def-fun/Marlin2SamplerWrapper/util/readme.md

# 工具脚本汇总

+ [calc_pos.py](calc_pos.py)计算样品瓶坐标

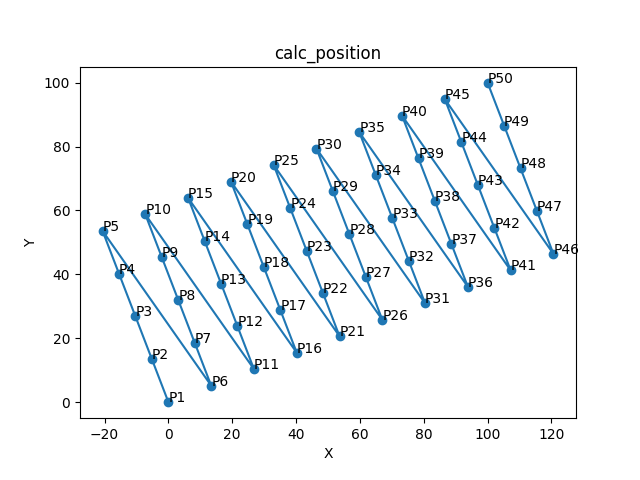
[picture p10: util/img/calc-position-plot.png]


生成和检查modbus通信payload

自动取样器上位机
