def-fun/Marlin2SamplerWrapper/doc/电子元件手册/LED/LED正负极区分.png

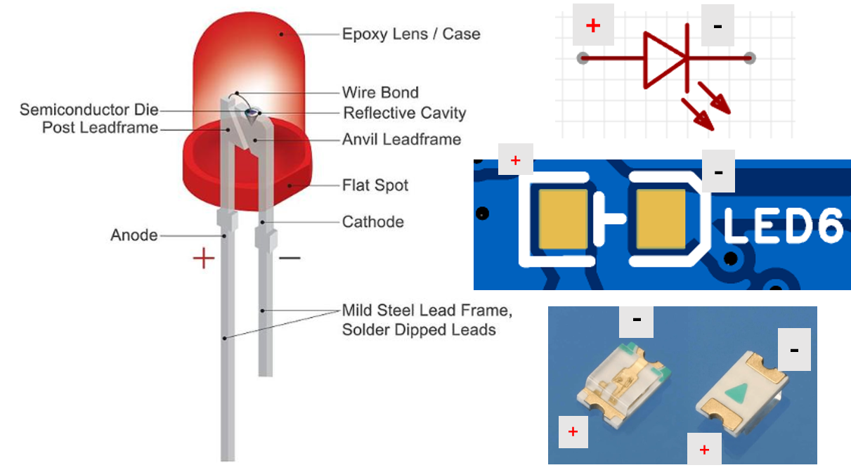
doc/电子元件手册/LED/LED正负极区分.png
