def-fun/Marlin2SamplerWrapper/img/calc_pos.jpg

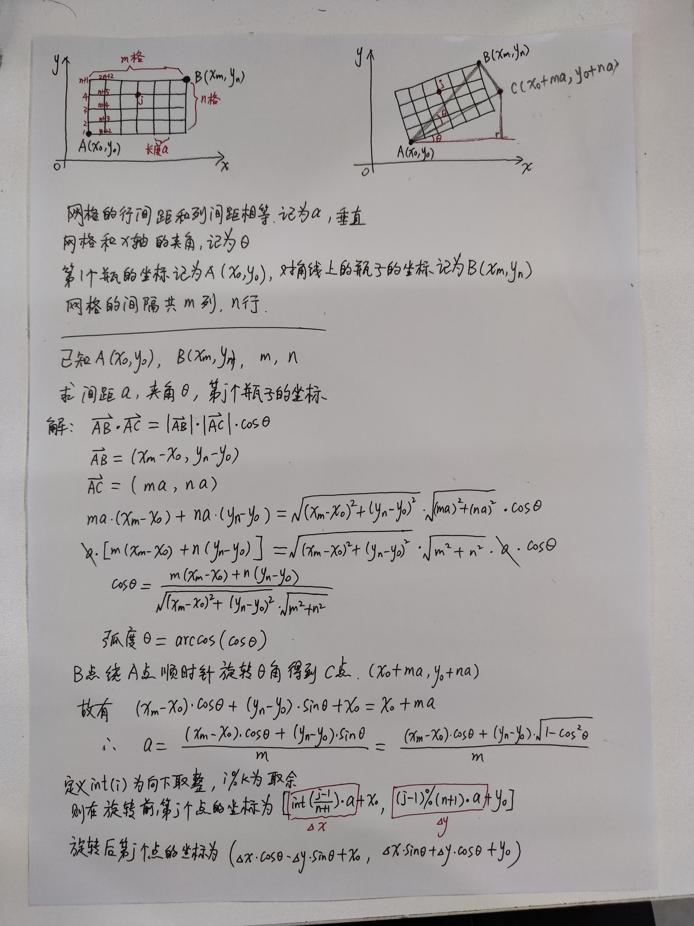
img/calc_pos.jpg
