def-fun/Marlin2SamplerWrapper/LCEDA-Pro/projects/Marlin2SamplerWrapper_backup/v1-20230606打板-图片.png

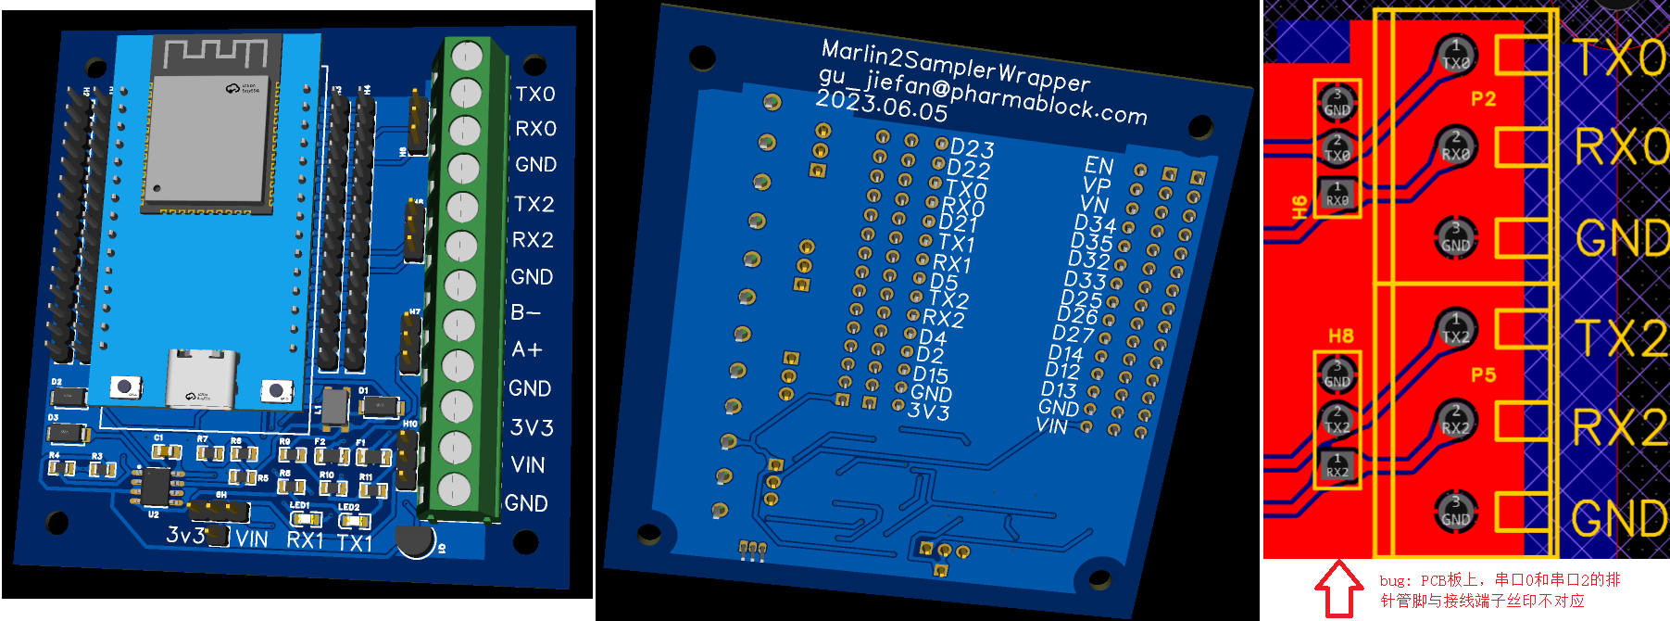
LCEDA-Pro/projects/Marlin2SamplerWrapper_backup/v1-20230606打板-图片.png
