def-fun/Marlin2SamplerWrapper/LCEDA-Pro/projects/Marlin2SamplerWrapper_backup/v2-20230615打板-图片.png

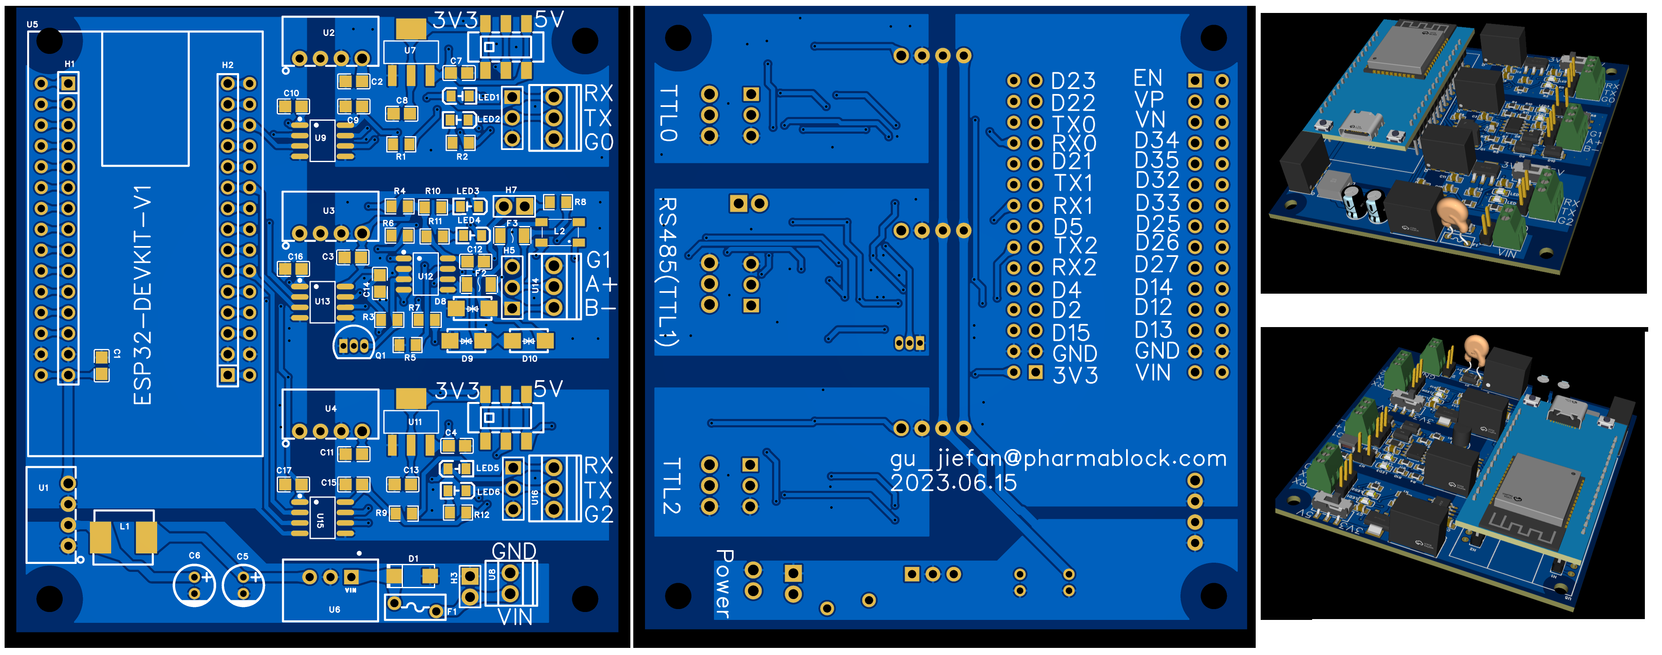
LCEDA-Pro/projects/Marlin2SamplerWrapper_backup/v2-20230615打板-图片.png
