def-fun/Marlin2SamplerWrapper/LCEDA-Pro/projects/Marlin2SamplerWrapper_backup/v3-20230623-PCB正面.png

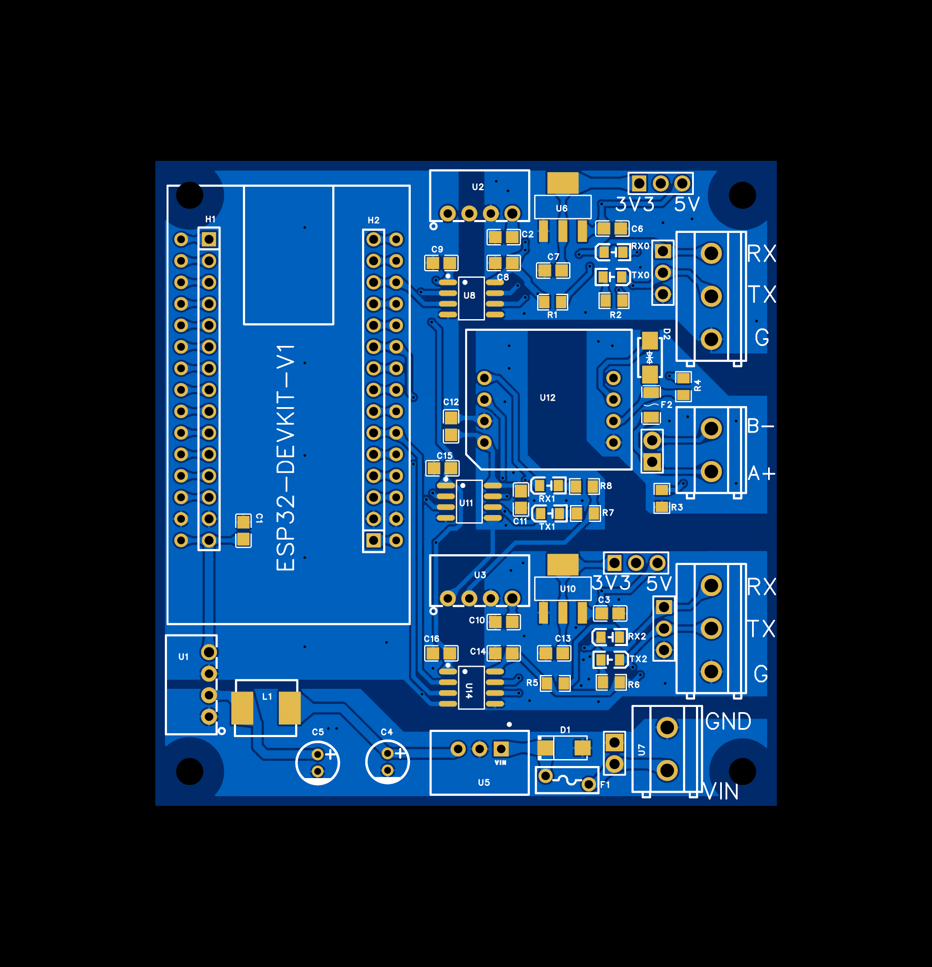
LCEDA-Pro/projects/Marlin2SamplerWrapper_backup/v3-20230623-PCB正面.png
