def-fun/Marlin2SamplerWrapper/LCEDA-Pro/projects/Marlin2SamplerWrapper_backup/v3-20230623-BOM.xlsx

No. | Quantity | Comment | Designator | Footprint | Manufacturer Part | Manufacturer | Supplier Part | Value | Primary Category | Secondary Category | Device | Name | Symbol
1 | 4 | 10uF | C1,C2,C3,C12 | C0805 | CL21A106KAYNNNE | SAMSUNG(三星) | C15850 | 10uF | 电容 | 贴片电容(MLCC) | CL21A106KAYNNNE_C15850 | 10uF | CL21A106KAYNNNE
2 | 2 | 22uF | C4,C5 | CAP-TH_BD5.0-P2.00-D0.8-FD | 50YXF22MEFC5X11 | rubycon(红宝石) | C88755 | 22uF | 电容 | 直插铝电解电容 | 50YXF22MEFC5X11 | 22uF | 50YXF22MEFC5X11
3 | 10 | 100nF | C6,C7,C8,C9,C10,C11,C13,C14,C15,C16 | C0805 | CC0805KRX7R9BB104 | YAGEO(国巨) | C49678 | 100nF | Capacitors | Multilayer Ceramic Capacitors MLCC - SMD/SMT | CC0805KRX7R9BB104 | 100nF | CL21A106KOQNNNE
4 | 1 | SS34 | D1 | SMA_L4.4-W2.6-LS5.0-RD | SS34 | Slkor(萨科微) | C408258 |  | 二极管 | 肖特基二极管 | SS34_C408258 | SS34 | SS34_C408258
5 | 1 | SMAJ12CA | D2 | SMA_L4.4-W2.6-LS5.0-BI | SMAJ12CA | MDD | C110042 |  | TVS/保险丝/板级保护 | 瞬态抑制二极管(TVS) | SMAJ12CA_C110042 | SMAJ12CA | SMAJ12CA-C110042
6 | 1 | BK60-050-DI | F1 | FUSE-TH_L7.4-W3.1-P5.10-D0.6-S1.00 | BK60-050-DI | Brightking(君耀电子) | C523023 |  | TVS/保险丝/板级保护 | 自恢复保险丝 | BK60-050-DI | BK60-050-DI | BK60-050-DI
7 | 1 | nSMD010 | F2 | F1206 | nSMD010 | 台湾陆海 | C70065 |  | TVS/保险丝/板级保护 | 自恢复保险丝 | nSMD010 | nSMD010 | nSMD010
8 | 2 | B-2100S15P-A110 | H1,H2 | HDR-TH_15P-P2.54-V-M | B-2100S15P-A110 | Ckmtw(灿科盟) | C124373 |  | 连接器 | 排针 | B-2100S15P-A110 | B-2100S15P-A110 | Header-Male-2.54_1x15
9 | 2 | PZ254V-11-02P | H3,H6 | HDR-TH_2P-P2.54-V-M | PZ254V-11-02P | XFCN(兴飞) | C492401 |  | 连接器 | 排针 | PZ254V-11-02P | PZ254V-11-02P | PZ254V-11-02P
10 | 4 | 2.54-1*3P针 | H4,H5,H7,H8 | HDR-TH_3P-P2.54-V-M-1 | 2.54-1*3P针 | BOOMELE(博穆精密) | C49257 |  | 连接器 | 排针 | 2.54-1*3P针 | 2.54-1*3P针 | Header-Male-2.54_1x3
11 | 1 | 47uH | L1 | IND-SMD_L7.1-W6.6_SLO0618H | SLO0650H470MTT | Sunltech(韩国顺磁) | C397794 | 47uH | 电感/线圈/变压器 | 功率电感 | SLO0650H470MTT | 47uH | SLO0650H470MTT
12 | 6 | 1kΩ | R1,R2,R5,R6,R7,R8 | R0805 | 0805W8F1001T5E | UNI-ROYAL(厚声) | C17513 | 1kΩ | Resistors | Chip Resistor - Surface Mount | 0805W8F1001T5E | 1kΩ | 电阻
13 | 2 | 4.7kΩ | R3,R4 | R0805 | 0805W8F4701T5E | UNI-ROYAL(厚声) | C17673 | 4.7kΩ | Resistors | Chip Resistor - Surface Mount | 0805W8F4701T5E | 4.7kΩ | 0805W8F1200T5E
14 | 6 | NCD0805R1 | RX0,RX1,RX2,TX0,TX1,TX2 | LED0805-RD_RED | NCD0805R1 | 国星光电 | C84256 |  | 光耦/LED/数码管/光电器件 | 发光二极管/LED | NCD0805R1 | NCD0805R1 | FC-2012HRK-620D
15 | 3 | B0505S-1WR3 | U1,U2,U3 | PWRM-TH_B0503S-1WR2 | B0505S-1WR3 | MORNSUN(金升阳) | C131038 |  | 电源芯片 | 电源模块 | B0505S-1WR3_C131038 | B0505S-1WR3 | B0505S-1WR3
16 | 1 |  | U4 | ESP32-devkit-30pin |  |  |  |  | 开发板 |  | ESP32-DEVKIT-V1(30pin) |  | ESP32-DEVKIT-V1(30pin)
17 | 1 | K7805-500R3 | U5 | PWRM-TH_K78XX-500R3 | K7805-500R3 | MORNSUN(金升阳) | C86735 |  | 电源芯片 | 电源模块 | K7805-500R3_C86735 | K7805-500R3 | K7805-500R3
18 | 2 | AMS1117-3.3 | U6,U10 | SOT-223-4_L6.5-W3.5-P2.30-LS7.0-BR | AMS1117-3.3 | UMW(广东友台半导体) | C347222 |  | 电源芯片 | 线性稳压器(LDO) | AMS1117-3.3_C347222 | AMS1117-3.3 | AMS1117-3.3_C347222
19 | 2 | KF127-5.08-2P | U7,U13 | CONN-TH_P5.08_KF127-5.08-2P | KF127-5.08-2P | KEFA(科发) | C474906 |  | 连接器 | 螺钉式接线端子 | KF127-5.08-2P | KF127-5.08-2P | KF127-5.08-2P
20 | 3 | π122U31 | U8,U11,U14 | SOIC-8_L4.9-W3.9-P1.27-LS6.0-BL | π122U31 | 2Pai Semi(荣湃) | C471590 |  | 通信接口芯片/UART/485/232 | 数字隔离器 | π122U31 | π122U31 | π122U31
21 | 2 | KF127-5.08-3P | U9,U15 | CONN-TH_3P-P5.08_KF127-5.08-3P | KF127-5.08-3P | KEFA(科发) | C474907 |  | 连接器 | 螺钉式接线端子 | KF127-5.08-3P | KF127-5.08-3P | KF127-5.08-3P
22 | 1 | RSM485PHT | U12 | COMM-TH_RSM485PHT | RSM485PHT | ZLG(致远电子) | C133735 |  | 物联网/通信模块 | RS485总线模块 | RSM485PHT_C133735 | RSM485PHT | RSM485PHT
