def-fun/Marlin2SamplerWrapper/LCEDA-Pro/projects/Marlin2SamplerWrapper_backup/v2-20230615打板-BOM.xlsx

No. | Quantity | Comment |  | Designator | Footprint | Manufacturer Part | Supplier Part | Value | Primary Category | Secondary Category | Name | Symbol
1 | 4 | 10uF | tb | C1,C2,C3,C4 | C0805 | CL21A106KAYNNNE | C15850 | 10uF | 电容 | 贴片电容(MLCC) | 10uF | CL21A106KAYNNNE
2 | 2 | 22uF | tb | C5,C6 | CAP-TH_BD5.0-P2.00-D0.8-FD | 50YXF22MEFC5X11 | C88755 | 22uF | 电容 | 直插铝电解电容 | 22uF | 50YXF22MEFC5X11
3 | 11 | 100nF | tb | C7,C8,C9,C10,C11,C12,C13,C14,C15,C16,C17 | C0805 | CC0805KRX7R9BB104 | C49678 | 100nF | Capacitors | Multilayer Ceramic Capacitors MLCC - SMD/SMT | 100nF | CL21A106KOQNNNE
4 | 1 | SS34 | tb | D1 | SMA_L4.4-W2.6-LS5.0-RD | SS34 | C408258 |  | 二极管 | 肖特基二极管 | SS34 | SS34_C408258
5 | 2 | SMAJ6.5CA | 嘉立创已买 | D8,D9 | SMA_L4.4-W2.6-LS5.0-BI | SMAJ6.5CA | C192922 |  | TVS/保险丝/板级保护 | 瞬态抑制二极管(TVS) | SMAJ6.5CA | SMAJ6.5CA_C192922
6 | 1 | SMAJ12CA | 嘉立创已买 | D10 | SMA_L4.4-W2.6-LS5.0-BI | SMAJ12CA | C110042 |  | TVS/保险丝/板级保护 | 瞬态抑制二极管(TVS) | SMAJ12CA | SMAJ12CA-C110042
7 | 1 | BK60-050-DI | tb | F1 | FUSE-TH_L7.4-W3.1-P5.10-D0.6-S1.00 | BK60-050-DI | C523023 |  | TVS/保险丝/板级保护 | 自恢复保险丝 | BK60-050-DI | BK60-050-DI
8 | 2 | nSMD010 | 嘉立创已买 | F2,F3 | F1206 | nSMD010 | C70065 |  | TVS/保险丝/板级保护 | 自恢复保险丝 | nSMD010 | nSMD010
9 | 2 | B-2100S15P-A110 | tb | H1,H2 | HDR-TH_15P-P2.54-V-M | B-2100S15P-A110 | C124373 |  | 连接器 | 排针 | B-2100S15P-A110 | Header-Male-2.54_1x15
10 | 2 | PZ254V-11-02P | tb | H3,H7 | HDR-TH_2P-P2.54-V-M | PZ254V-11-02P | C492401 |  | 连接器 | 排针 | PZ254V-11-02P | PZ254V-11-02P
11 | 3 | 2.54-1*3P针 | tb | H4,H5,H6 | HDR-TH_3P-P2.54-V-M-1 | 2.54-1*3P针 | C49257 |  | 连接器 | 排针 | 2.54-1*3P针 | Header-Male-2.54_1x3
12 | 1 | 47uH | 嘉立创 | L1 | IND-SMD_L7.1-W6.6_SLO0618H | SLO0650H470MTT | C397794 | 47uH | 电感/线圈/变压器 | 功率电感 | 47uH | SLO0650H470MTT
13 | 1 | ACT45B-510-2P-TL003 | 嘉立创已买 | L2 | IND-SMD_4P-L4.5-W3.2-TL | ACT45B-510-2P-TL003 | C76584 |  | 磁珠/滤波器/EMI优化 | 共模滤波器 | ACT45B-510-2P-TL003 | ACT45B-510-2P-TL003
14 | 6 | NCD0805R1 | 已有 | LED1,LED2,LED3,LED4,LED5,LED6 | LED0805-RD_RED | NCD0805R1 | C84256 |  | 光耦/LED/数码管/光电器件 | 发光二极管/LED | NCD0805R1 | FC-2012HRK-620D
15 | 1 | S8050 | tb | Q1 | TO-92-3_L4.9-W3.7-P1.27-L | S8050 | C8327 |  | 三极管/MOS管/晶体管 | 三极管(BJT) | S8050 | S8050_C8327
16 | 6 | 1kΩ | tb | R1,R2,R9,R10,R11,R12 | R0805 | 0805W8F1001T5E | C17513 | 1kΩ | Resistors | Chip Resistor - Surface Mount | 1kΩ | 电阻
17 | 5 | 4.7kΩ | tb | R3,R4,R5,R6,R7 | R0805 | 0805W8F4701T5E | C17673 | 4.7kΩ | Resistors | Chip Resistor - Surface Mount | 4.7kΩ | 0805W8F1200T5E,电阻
18 | 1 | 120Ω |  | R8 | R0805 | 0805W8F1200T5E | C17437 | 120Ω | 电阻 | 贴片电阻 | 120Ω | 0805W8F1200T5E
19 | 2 | MST22D18G2 125 | 嘉立创 | SW1,SW2 | SW-SMD_MST22D18G2 | MST22D18G2 125 | C2906280 |  | 按键/开关 | 滑动开关 | MST22D18G2 125 | MST22D18G2 125
20 | 4 | B0505S-1WR3 | tb | U1,U2,U3,U4 | PWRM-TH_B0503S-1WR2 | B0505S-1WR3 | C131038 |  | 电源芯片 | 电源模块 | B0505S-1WR3 | B0505S-1WR3
21 | 1 |  | 已有 | U5 | ESP32-devkit-30pin |  |  |  | 开发板 |  |  | ESP32-DEVKIT-V1(30pin)
22 | 1 | K7805-500R3 | tb | U6 | PWRM-TH_K78XX-500R3 | K7805-500R3 | C86735 |  | 电源芯片 | 电源模块 | K7805-500R3 | K7805-500R3
23 | 2 | AMS1117-3.3 | tb | U7,U11 | SOT-223-4_L6.5-W3.5-P2.30-LS7.0-BR | AMS1117-3.3 | C347222 |  | 电源芯片 | 线性稳压器(LDO) | AMS1117-3.3 | AMS1117-3.3_C347222
24 | 1 | KF128-2.54-2P | 已有 | U8 | CONN-TH_P2.54_KF128-2.54-2P | KF128-2.54-2P | C474920 |  | 连接器 | 螺钉式接线端子 | KF128-2.54-2P | KF128-2.54-2P
25 | 3 | π122U31 | tb | U9,U13,U15 | SOIC-8_L4.9-W3.9-P1.27-LS6.0-BL | π122U31 | C471590 |  | 通信接口芯片/UART/485/232 | 数字隔离器 | π122U31 | π122U31
26 | 3 | KF128-2.54-3P | 已有 | U10,U14,U16 | CONN-TH_3P-P2.54_KF128-2.54-3P | KF128-2.54-3P | C474921 |  | 连接器 | 螺钉式接线端子 | KF128-2.54-3P | KF128-2.54-3P
27 | 1 | GM3085E | 嘉立创已买 | U12 | SOP-8_L4.9-W3.9-P1.27-LS6.0-BL | GM3085E | C269864 |  | 通信接口芯片/UART/485/232 | RS-485/RS-422芯片 | GM3085E | GM3085E
