def-fun/Marlin2SamplerWrapper/test-src/readme.md

[test-led-and-serials.ino](test-led-and-serials.ino)无需外部接线，用于测试、验证ESP32开发板的LED和串口以及ESP32的开发环境
