def-fun/Marlin2SamplerWrapper/LCEDA-Pro/projects/Marlin2SamplerWrapper_backup/v3-20230623-原理图.pdf

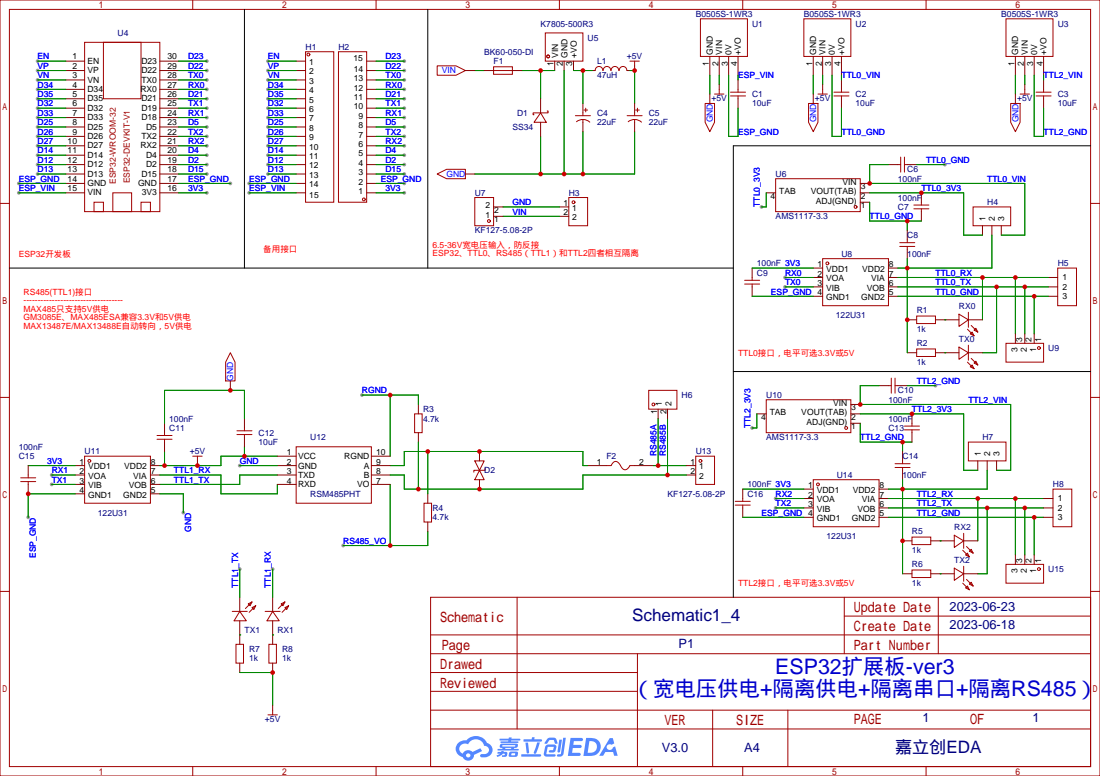
[picture p17: page 1]
