def-fun/Marlin2SamplerWrapper/LCEDA-Pro/projects/Marlin2SamplerWrapper_backup/v1-20230606打板-原理图.pdf

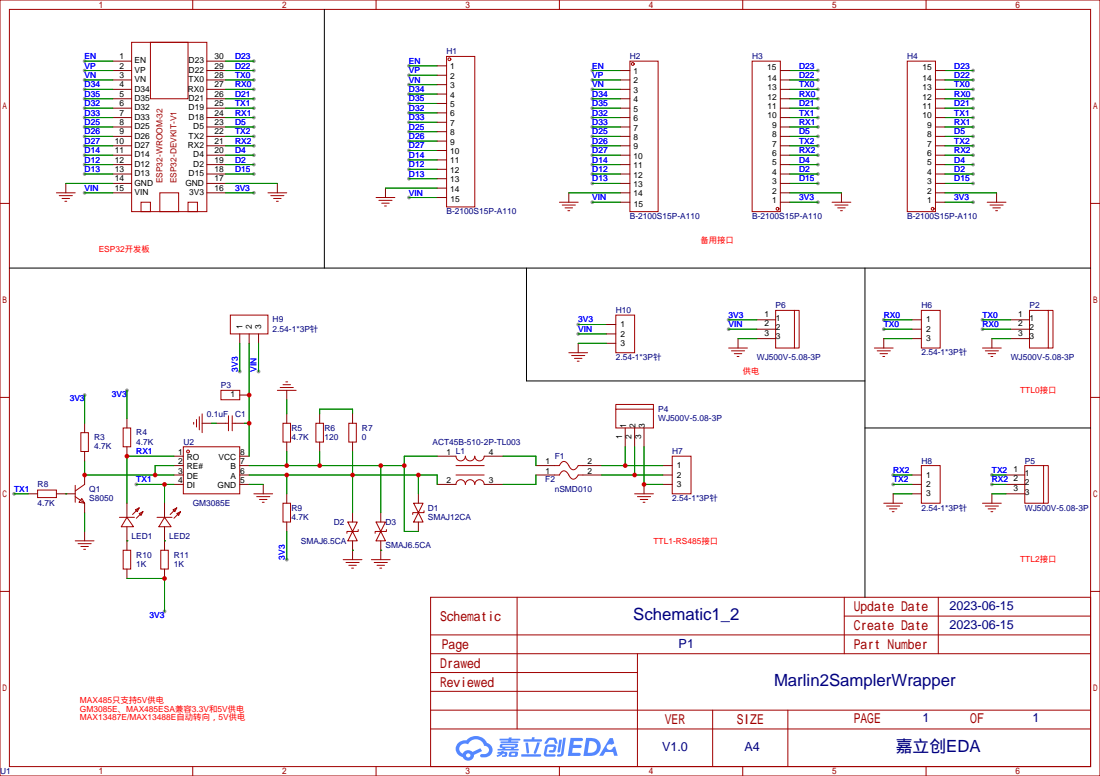
[picture p18: page 1]
