def-fun/Marlin2SamplerWrapper/LCEDA-Pro/projects/Marlin2SamplerWrapper_backup/v2-20230615打板-原理图.pdf

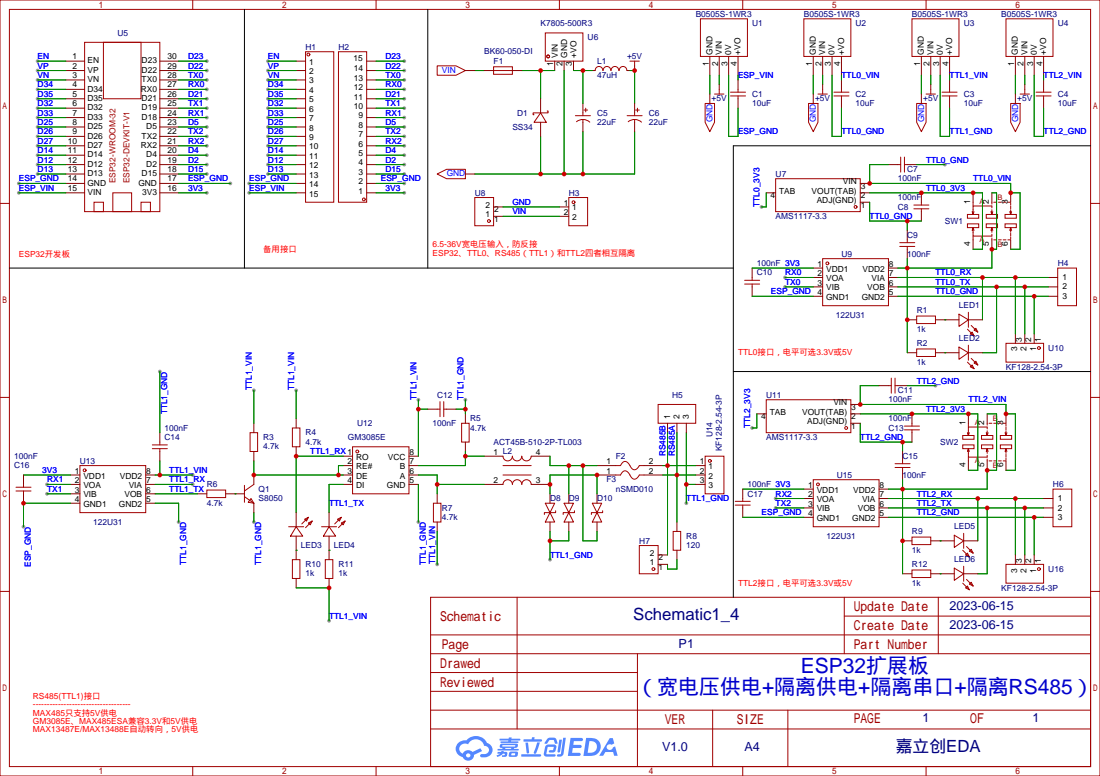
[picture p19: page 1]
