def-fun/Marlin2SamplerWrapper/(list of files, drawings)

Other design files:
LCEDA-Pro/projects/Marlin2SamplerWrapper.eprj
