def-fun/Marlin2SamplerWrapper/(commit log)

2023-06-01 完成三串口测试
    [通讯协议.xlsx]
2023-06-02 实现读取Serial1的数据，处理后向各个串口发出
    [通讯协议.xlsx]
2023-06-02 算法改进：根据瓶子编号计算瓶子的坐标
2023-06-05 添加立创EDA专业版的PCB文件
    [Marlin2SamplerWrapper.eprj]
2023-06-05 修改modbus协议
    [通讯协议.xlsx]
2023-06-05 PCB布线前备份
2023-06-06 20230606, 第一版PCB绘制完成，给嘉立创打板
    [Marlin2SamplerWrapper.eprj]
2023-06-06 记录一些神奇的bug
2023-06-07 Serial输出更详细的调试信息
    [Marlin2SamplerWrapper.eprj, 通讯协议.xlsx]
2023-06-07 计算所有点的坐标，并用matplotlib画图
2023-06-08 使用正则解析XYZ坐标，编译通过，待烧录测试
2023-06-12 发现PCB板bug：串口0和串口2的排针管脚与接线端子丝印不对应
2023-06-12 vofa+串口调试工具的侧边栏命令的配置文件
2023-06-13 添加元件文档和电路设计策略
    [Marlin2SamplerWrapper.eprj]
2023-06-13 frame2用String存储；实现了对M114返回值的解析，得到XYZ坐标
    [Marlin2SamplerWrapper.eprj]
2023-06-13 （暂存）可能是unsigned char和int之间的数据转换出了问题，modbus read的结果不正确
2023-06-14 删减`main.ino`，可重现位号错误的bug
2023-06-14 发现bug是由`POINTS_?`数组初始化不完全导致，使用for循环把所有元素覆盖为1025.0可解决
2023-06-14 修复瓶位记录错误的bug
2023-06-14 经测试，可控制打印机运动到各个瓶位
2023-06-15 做第二版EPS32扩展板 + 防反接 + 4.5-36伏宽电压输入 + ESP32供电、串口、RS485互相隔离
    [通讯协议.xlsx]
2023-06-18 添加v2的BOM表
    [v2-20230615打板-BOM.xlsx]
2023-06-18 修改拼错的单词；通过122U31隔离模块在921600波特率烧录失败，降低波特率至115200后成功
2023-06-18 第二版PCB焊接并调试完成，通信和供电均互相隔离，抗干扰能力强；RS485需要升级
2023-06-20 和触摸屏联调通过
2023-06-23 第三版PCB：使用RSM485PHT作为TTL转RS485的隔离模块；接线端子间距5.08mm，接线方便；跳线帽取代贴片滑动开关，占地少
    [v3-20230623-BOM.xlsx]
2023-06-25 03功能码支持读取多个字节
2023-07-25 和田浩PLC调试通过
2023-09-05 和PLC通信测试，基本没问题 田浩反馈说发送下针命令时，寄存器会立刻返回2，之后变成0，最后又变成2
2023-09-12 尝试解决bug：接收到针头运动指令，立刻返回`已到达目的地`
2023-12-17 更正管脚定义
